aniranaway/Drone_Swarm/hardware/swarm_drone.kicad_pcb

## KiCad design hardware/swarm_drone.kicad_pcb (2026-10-28)

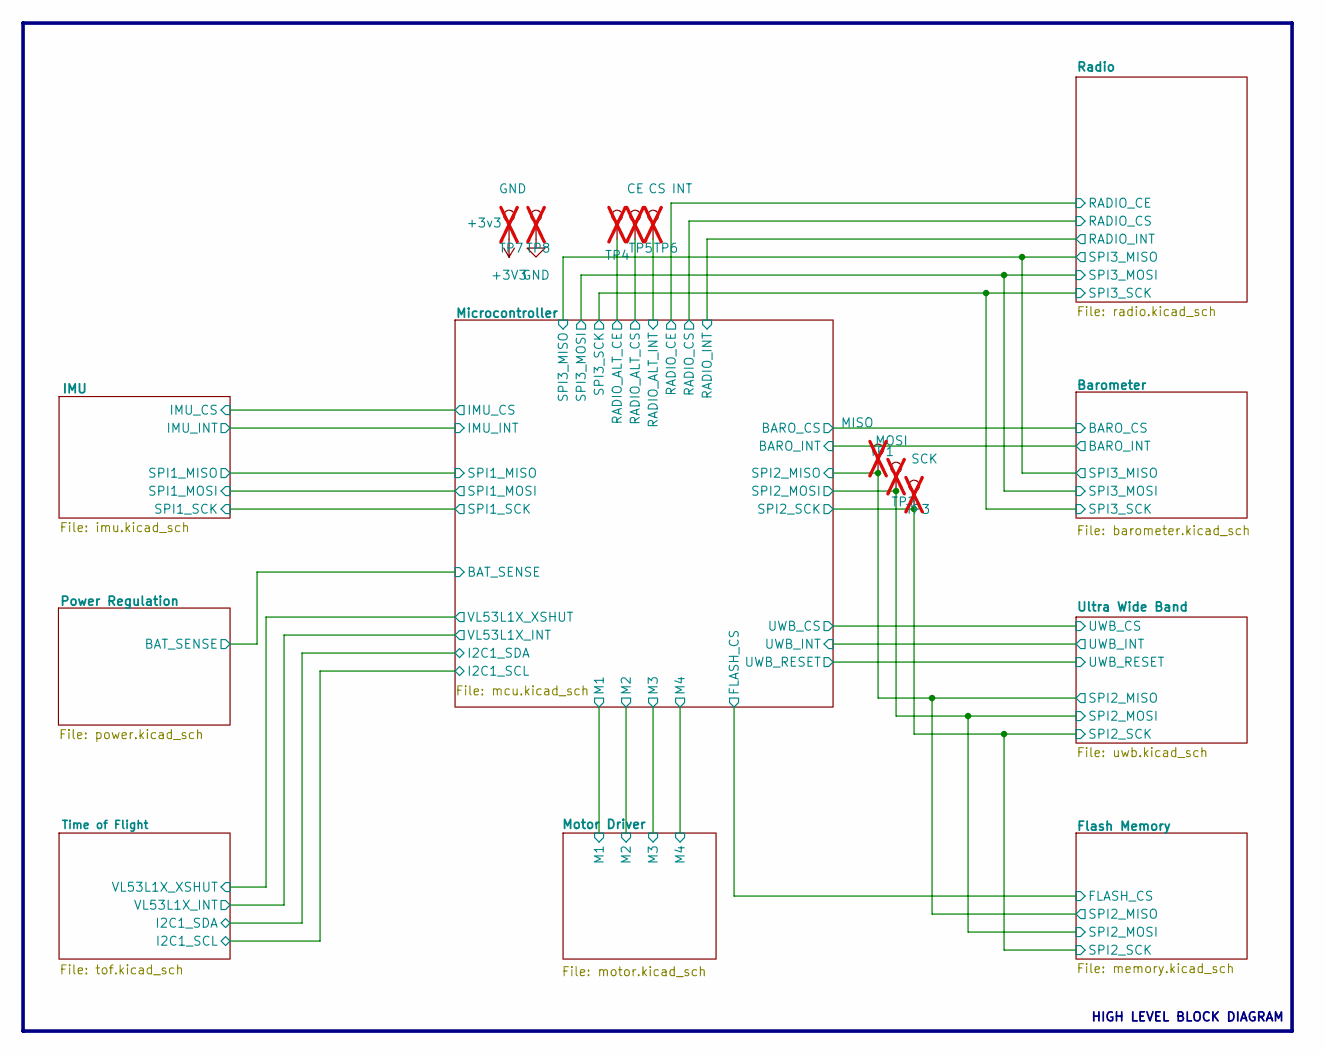
[picture p1: schematic swarm_drone.kicad_sch]

Parts:
TP1: MISO; TestPoint_Pad_1.0x1.0mm; not fitted
TP2: MOSI; TestPoint_Pad_1.0x1.0mm; not fitted
TP3: SCK; TestPoint_Pad_1.0x1.0mm; not fitted
TP4: CE; TestPoint_Pad_1.0x1.0mm; not fitted
TP5: CS; TestPoint_Pad_1.0x1.0mm; not fitted
TP6: INT; TestPoint_Pad_1.0x1.0mm; not fitted
TP7: +3v3; TestPoint_Pad_1.0x1.0mm; not fitted
TP8: GND; TestPoint_Pad_1.0x1.0mm; not fitted

Connections:
+3V3: TP7.1 (1_1); also elsewhere on the board
/Flash Memory/SPI2_MISO: TP1.1 (1_1); also elsewhere on the board
/Flash Memory/SPI2_MOSI: TP2.1 (1_1); also elsewhere on the board
/Flash Memory/SPI2_SCK: TP3.1 (1_1); also elsewhere on the board
/Microcontroller/RADIO_ALT_CE: TP4.1 (1_1); also elsewhere on the board
/Microcontroller/RADIO_ALT_CS: TP5.1 (1_1); also elsewhere on the board
/Microcontroller/RADIO_ALT_INT: TP6.1 (1_1); also elsewhere on the board
GND: TP8.1 (1_1); also elsewhere on the board

Notes on the sheet:
HIGH LEVEL BLOCK DIAGRAM

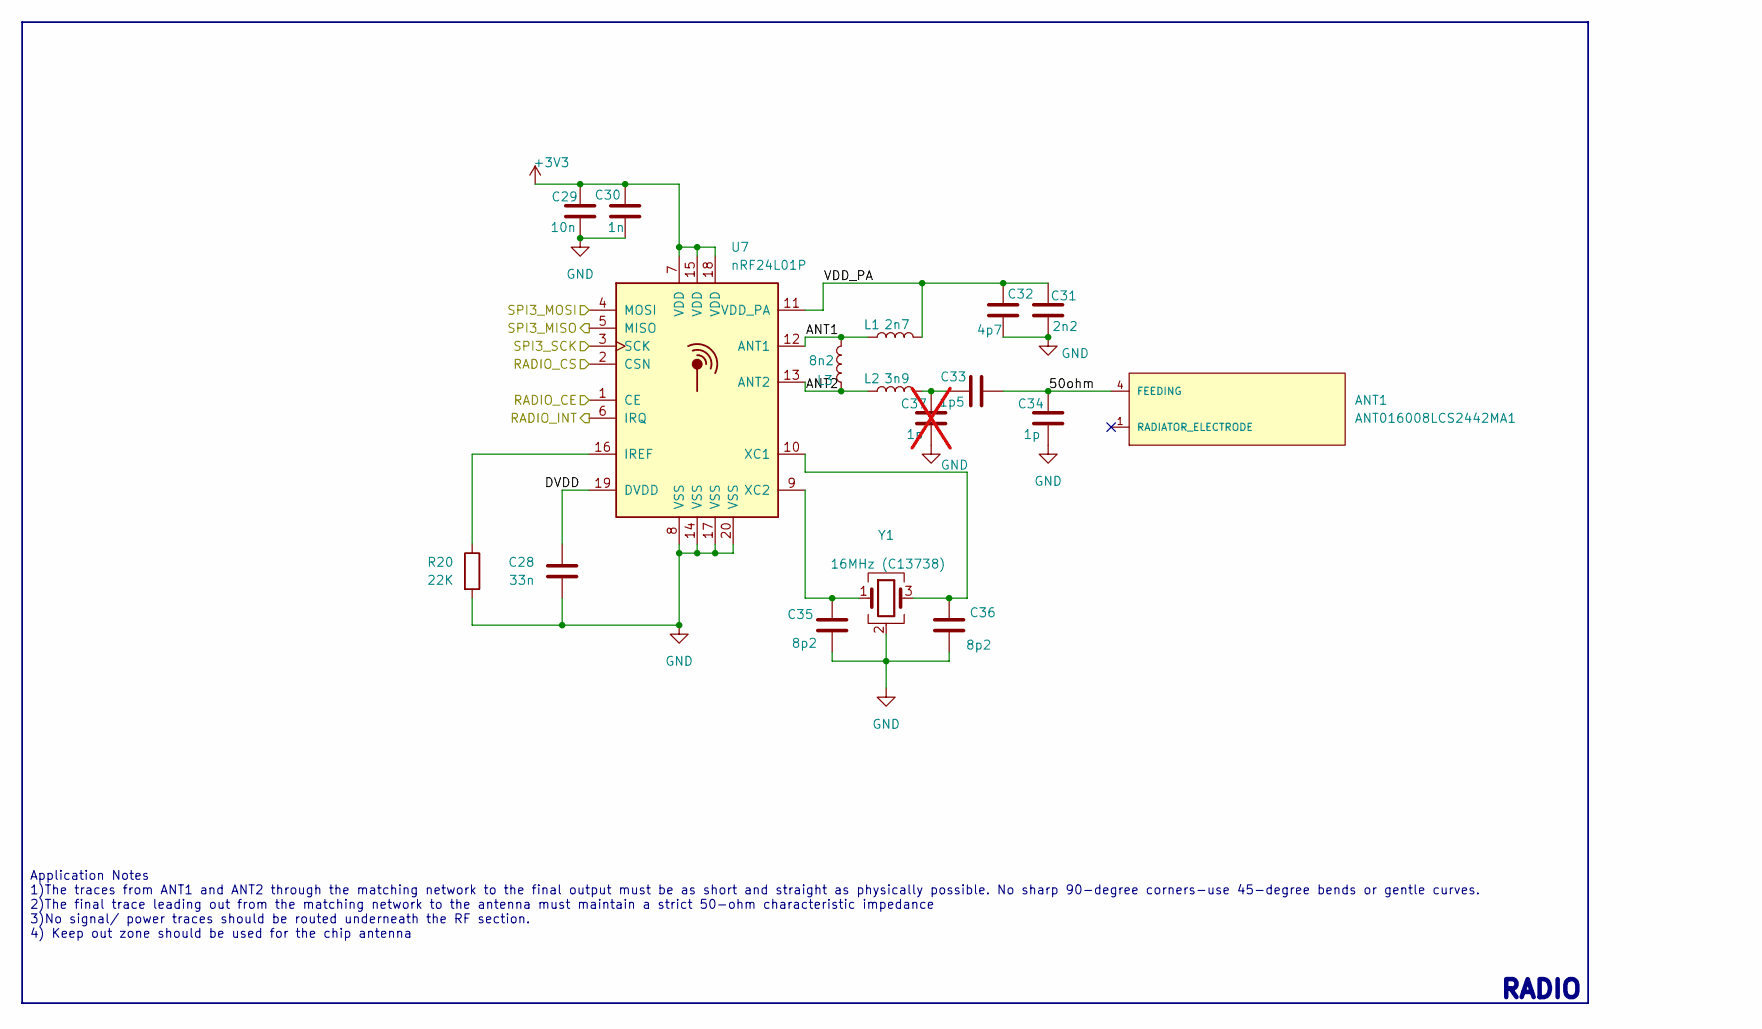
[picture p2: schematic radio.kicad_sch]

Parts:
ANT1: ANT016008LCS2442MA1; ANT_ANT016008LCS2442MA1; PARTREV sep 2016; LCSC C76585
C28: 33n; C_0603_1608Metric; LCSC C21117
C29: 10n; C_0402_1005Metric; LCSC C15195
C30: 1n; C_0402_1005Metric; LCSC C1523
C31: 2n2; C_0603_1608Metric; LCSC C1604
C32: 4p7; C_0402_1005Metric; LCSC C1569
C33: 1p5; C_0402_1005Metric; LCSC C1552
C34: 1p; C_0402_1005Metric; LCSC C1550
C35, C36: 8p2; C_0402_1005Metric; LCSC C1579
C37: 1p; C_0402_1005Metric; not fitted
L1: 2n7; L_0402_1005Metric
L2: 3n9; L_0402_1005Metric
L3: 8n2; L_0402_1005Metric
R20: 22K; R_0402_1005Metric; LCSC C25768
U7: nRF24L01P; QFN-20-1EP_4x4mm_P0.5mm_EP2.5x2.5mm; LCSC C8791
Y1: 16MHz (C13738); Crystal_SMD_3225-4Pin_3.2x2.5mm; LCSC C13738

Connections:
+3V3: C29.1, C30.1, U7.7 (VDD), U7.15 (VDD), U7.18 (VDD); also elsewhere on the board
/Barometer/SPI3_MISO: U7.5 (MISO); also elsewhere on the board
/Barometer/SPI3_MOSI: U7.4 (MOSI); also elsewhere on the board
/Barometer/SPI3_SCK: U7.3 (SCK); also elsewhere on the board
/Microcontroller/RADIO_CE: U7.1 (CE); also elsewhere on the board
/Microcontroller/RADIO_CS: U7.2 (CSN); also elsewhere on the board
/Microcontroller/RADIO_INT: U7.6 (IRQ); also elsewhere on the board
/Radio/50ohm: ANT1.4 (FEEDING_4), C33.2, C34.2
/Radio/ANT1: L1.1, L3.2, U7.12 (ANT1)
/Radio/ANT2: L2.1, L3.1, U7.13 (ANT2)
/Radio/DVDD: C28.1, U7.19 (DVDD)
/Radio/VDD_PA: C31.1, C32.1, L1.2, U7.11 (VDD_PA)
GND: C28.2, C29.2, C30.2, C31.2, C32.2, C34.1, C35.2, C36.2, C37.1, R20.2, U7.8 (VSS), U7.14 (VSS), U7.17 (VSS), U7.20 (VSS), Y1.2 (G), Y1.4 (G); also elsewhere on the board
unnamed: C33.1, C37.2, L2.2
unnamed: R20.1, U7.16 (IREF)
unnamed: C36.1, U7.10 (XC1), Y1.3
unnamed: C35.1, U7.9 (XC2), Y1.1

Notes on the sheet:
RADIO
Application Notes 1)The traces from ANT1 and ANT2 through the matching network to the final output must be as short and straight as physically possible. No sharp 90-degree corners-use 45-degree bends or gentle curves. 2)The final trace leading out from the matching network to the antenna must maint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

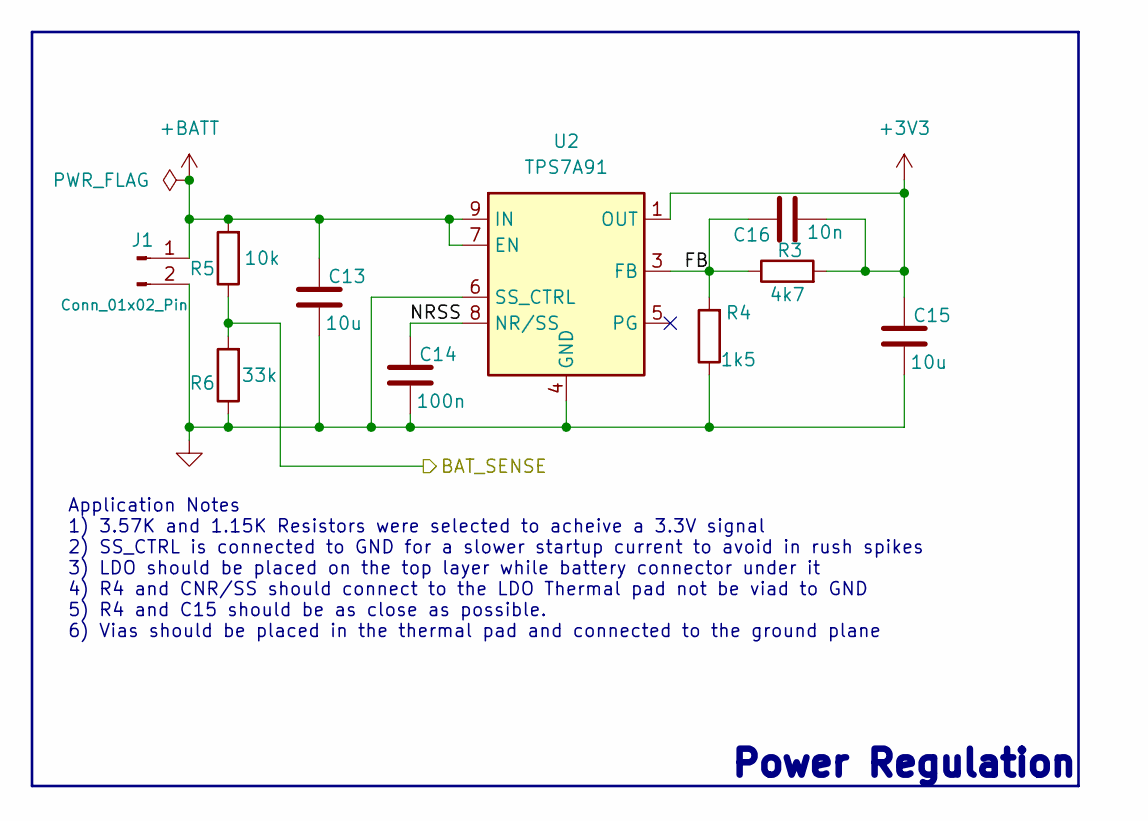
[picture p3: schematic power.kicad_sch]

Parts:
C13, C15: 10u; C_0603_1608Metric; LCSC C19702
C14: 100n; C_0402_1005Metric; LCSC C1525
C16: 10n; C_0402_1005Metric; LCSC C15195
J1: Conn_01x02_Pin; JST_PH_S2B-PH-K_1x02_P2.00mm_Horizontal; LCSC C173752
R3: 4k7; R_0402_1005Metric; LCSC C25900
R4: 1k5; R_0402_1005Metric; LCSC C25867
R5: 10k; R_0402_1005Metric; LCSC C25744
R6: 33k; R_0402_1005Metric; LCSC C25779
U2: TPS7A91; Texas_S-PDSO-N10_EP1.2x2mm_ThermalVias; LCSC C969024

Connections:
+3V3: C15.1, C16.2, R3.2, U2.1 (OUT), U2.2 (OUT); also elsewhere on the board
+BATT: C13.1, J1.1, R5.2, U2.7 (EN), U2.9 (IN), U2.10 (IN); also elsewhere on the board
/Microcontroller/BAT_SENSE: R5.1, R6.2; also elsewhere on the board
/Power Regulation/FB: C16.1, R3.1, R4.2, U2.3 (FB)
/Power Regulation/NRSS: C14.1, U2.8 (NR/SS)
GND: C13.2, C14.2, C15.2, J1.2, R4.1, R6.1, U2.4 (GND), U2.6 (SS_CTRL), U2.11 (GND); also elsewhere on the board

Notes on the sheet:
Application Notes 1) 3.57K and 1.15K Resistors were selected to acheive a 3.3V signal 2) SS_CTRL is connected to GND for a slower startup current to avoid in rush spikes 3) LDO should be placed on the top layer while battery connector under it 4) R4 and CNR/SS should connect to the LDO Thermal pad 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
Power Regulation

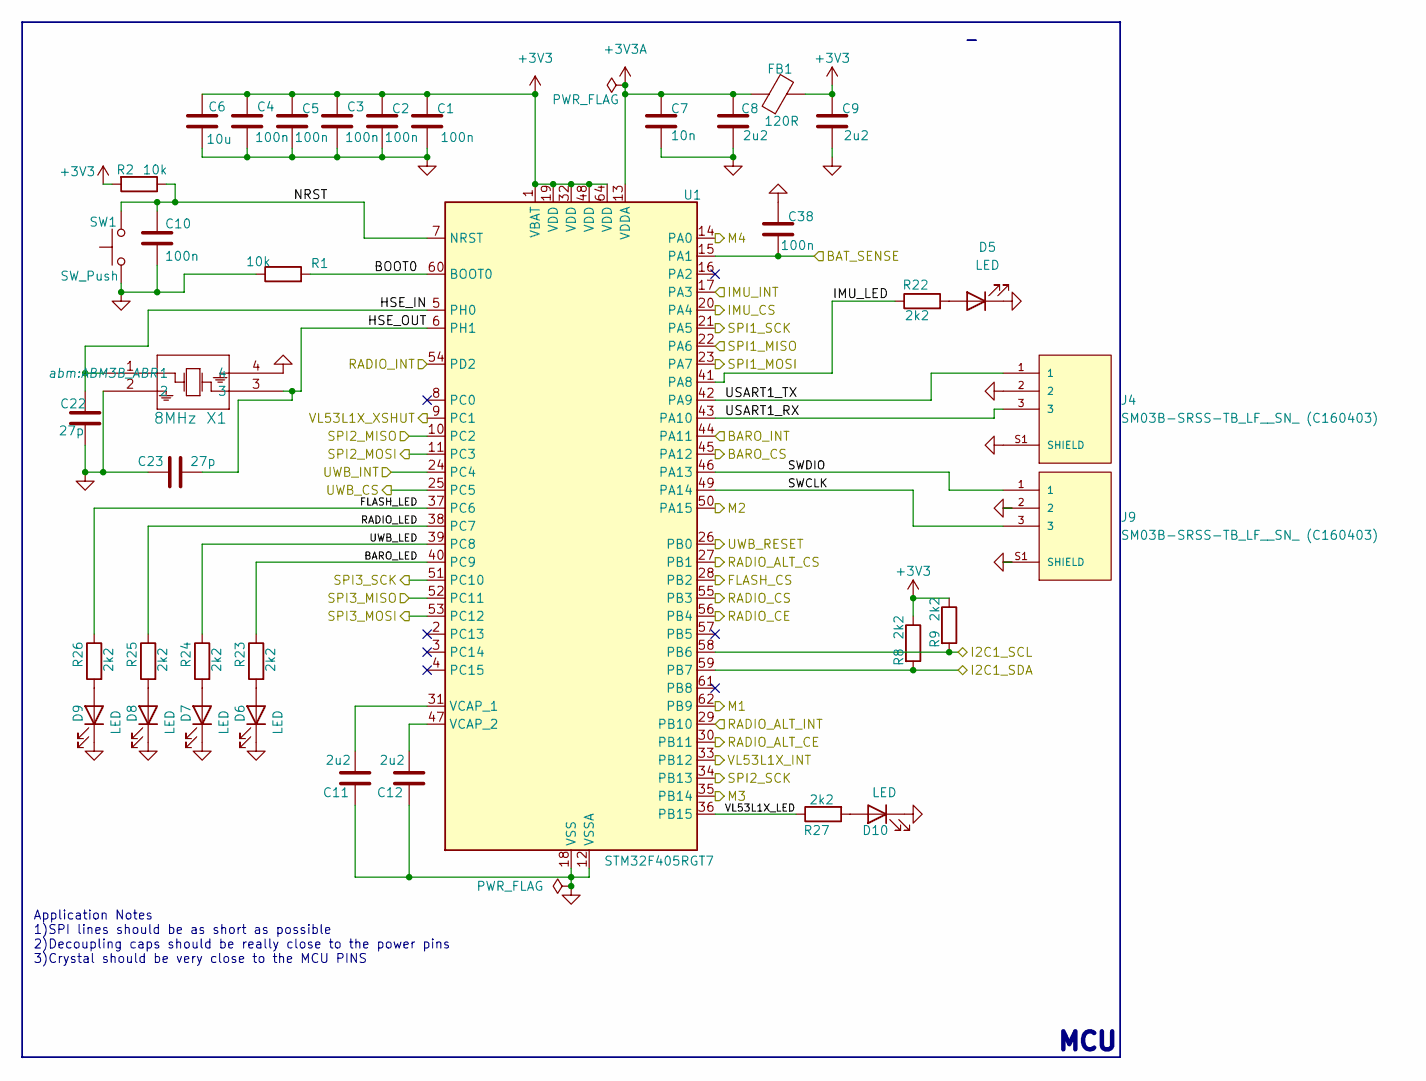
[picture p4: schematic mcu.kicad_sch]

Parts:
C1, C2, C3, C4, C5, C10, C38: 100n; C_0402_1005Metric; LCSC C1525
C6: 10u; C_0603_1608Metric; LCSC C19702
C7: 10n; C_0402_1005Metric; LCSC C15195
C8, C9, C11, C12: 2u2; C_0402_1005Metric; LCSC C12530
C22, C23: 27p; C_0402_1005Metric; LCSC C1557
D5, D6, D7, D8, D9, D10: LED; LED_0603_1608Metric; LCSC C2286
FB1: 120R; L_0603_1608Metric; LCSC C14709
J4, J9: SM03B-SRSS-TB_LF__SN_ (C160403); JST_SM03B-SRSS-TB_LF__SN_; LCSC C160403
R1, R2: 10k; R_0402_1005Metric; LCSC C25744
R8, R9, R22, R23, R24, R25, R26, R27: 2k2; R_0402_1005Metric; LCSC C25879
SW1: SW_Push; SW_SPST_TS-1088-xR020; LCSC C720477
U1: STM32F405RGT7; LQFP-64_10x10mm_P0.5mm; LCSC C1337199
X1: 8MHz; ABM3B_ABR; LCSC C83312

Connections:
+3V3: C1.1, C2.1, C3.1, C4.1, C5.1, C6.1, C9.1, FB1.2, R2.2, R8.1, R9.1, U1.1 (VBAT), U1.19 (VDD), U1.32 (VDD), U1.48 (VDD), U1.64 (VDD); also elsewhere on the board
+3V3A: C7.1, C8.1, FB1.1, U1.13 (VDDA)
/Barometer/BARO_CS: U1.45 (PA12); also elsewhere on the board
/Barometer/BARO_INT: U1.44 (PA11); also elsewhere on the board
/Barometer/SPI3_MISO: U1.52 (PC11); also elsewhere on the board
/Barometer/SPI3_MOSI: U1.53 (PC12); also elsewhere on the board
/Barometer/SPI3_SCK: U1.51 (PC10); also elsewhere on the board
/Flash Memory/FLASH_CS: U1.28 (PB2); also elsewhere on the board
/Flash Memory/SPI2_MISO: U1.10 (PC2); also elsewhere on the board
/Flash Memory/SPI2_MOSI: U1.11 (PC3); also elsewhere on the board
/Flash Memory/SPI2_SCK: U1.34 (PB13); also elsewhere on the board
/IMU/IMU_CS: U1.20 (PA4); also elsewhere on the board
/IMU/IMU_INT: U1.17 (PA3); also elsewhere on the board
/IMU/SPI1_MISO: U1.22 (PA6); also elsewhere on the board
/IMU/SPI1_MOSI: U1.23 (PA7); also elsewhere on the board
/IMU/SPI1_SCK: U1.21 (PA5); also elsewhere on the board
/Microcontroller/BARO_LED: R23.1, U1.40 (PC9)
/Microcontroller/BAT_SENSE: C38.2, U1.15 (PA1); also elsewhere on the board
/Microcontroller/BOOT0: R1.2, U1.60 (BOOT0)
/Microcontroller/FLASH_LED: R26.1, U1.37 (PC6)
/Microcontroller/HSE_IN: C22.1, U1.5 (PH0), X1.1
/Microcontroller/HSE_OUT: C23.2, U1.6 (PH1), X1.3
/Microcontroller/I2C1_SCL: R9.2, U1.58 (PB6); also elsewhere on the board
/Microcontroller/I2C1_SDA: R8.2, U1.59 (PB7); also elsewhere on the board
/Microcontroller/IMU_LED: R22.1, U1.41 (PA8)
/Microcontroller/M1: U1.62 (PB9); also elsewhere on the board
/Microcontroller/M2: U1.50 (PA15); also elsewhere on the board
/Microcontroller/M3: U1.35 (PB14); also elsewhere on the board
/Microcontroller/M4: U1.14 (PA0); also elsewhere on the board
/Microcontroller/NRST: C10.1, R2.1, SW1.2, U1.7 (NRST)
/Microcontroller/RADIO_ALT_CE: U1.30 (PB11); also elsewhere on the board
/Microcontroller/RADIO_ALT_CS: U1.27 (PB1); also elsewhere on the board
/Microcontroller/RADIO_ALT_INT: U1.29 (PB10); also elsewhere on the board
/Microcontroller/RADIO_CE: U1.56 (PB4); also elsewhere on the board
/Microcontroller/RADIO_CS: U1.55 (PB3); also elsewhere on the board
/Microcontroller/RADIO_INT: U1.54 (PD2); also elsewhere on the board
/Microcontroller/RADIO_LED: R25.1, U1.38 (PC7)
/Microcontroller/SWCLK: J9.3, U1.49 (PA14)
/Microcontroller/SWDIO: J9.1, U1.46 (PA13)
/Microcontroller/USART1_RX: J4.3, U1.43 (PA10)
/Microcontroller/USART1_TX: J4.1, U1.42 (PA9)
/Microcontroller/UWB_CS: U1.25 (PC5); also elsewhere on the board
/Microcontroller/UWB_INT: U1.24 (PC4); also elsewhere on the board
/Microcontroller/UWB_LED: R24.1, U1.39 (PC8)
/Microcontroller/UWB_RESET: U1.26 (PB0); also elsewhere on the board
/Microcontroller/VL53L1X_INT: U1.33 (PB12); also elsewhere on the board
/Microcontroller/VL53L1X_LED: R27.1, U1.36 (PB15)
/Microcontroller/VL53L1X_XSHUT: U1.9 (PC1); also elsewhere on the board
GND: C1.2, C2.2, C3.2, C4.2, C5.2, C6.2, C7.2, C8.2, C9.2, C10.2, C11.1, C12.1, C22.2, C23.1, C38.1, D5.1 (K), D6.1 (K), D7.1 (K), D8.1 (K), D9.1 (K), D10.1 (K), J4.2, J4.S1 (SHIELD), J4.S2 (SHIELD), J9.2, J9.S1 (SHIELD), J9.S2 (SHIELD), R1.1, SW1.1, U1.12 (VSSA), U1.18 (VSS), U1.63 (VSS), X1.2, X1.4; also elsewhere on the board
unnamed: D5.2 (A), R22.2
unnamed: D6.2 (A), R23.2
unnamed: D7.2 (A), R24.2
unnamed: D8.2 (A), R25.2
unnamed: D9.2 (A), R26.2
unnamed: D10.2 (A), R27.2
unnamed: C11.2, U1.31 (VCAP_1)
unnamed: C12.2, U1.47 (VCAP_2)

Notes on the sheet:
Application Notes 1)SPI lines should be as short as possible 2)Decoupling caps should be really close to the power pins 3)Crystal should be very close to the MCU PINS
MCU

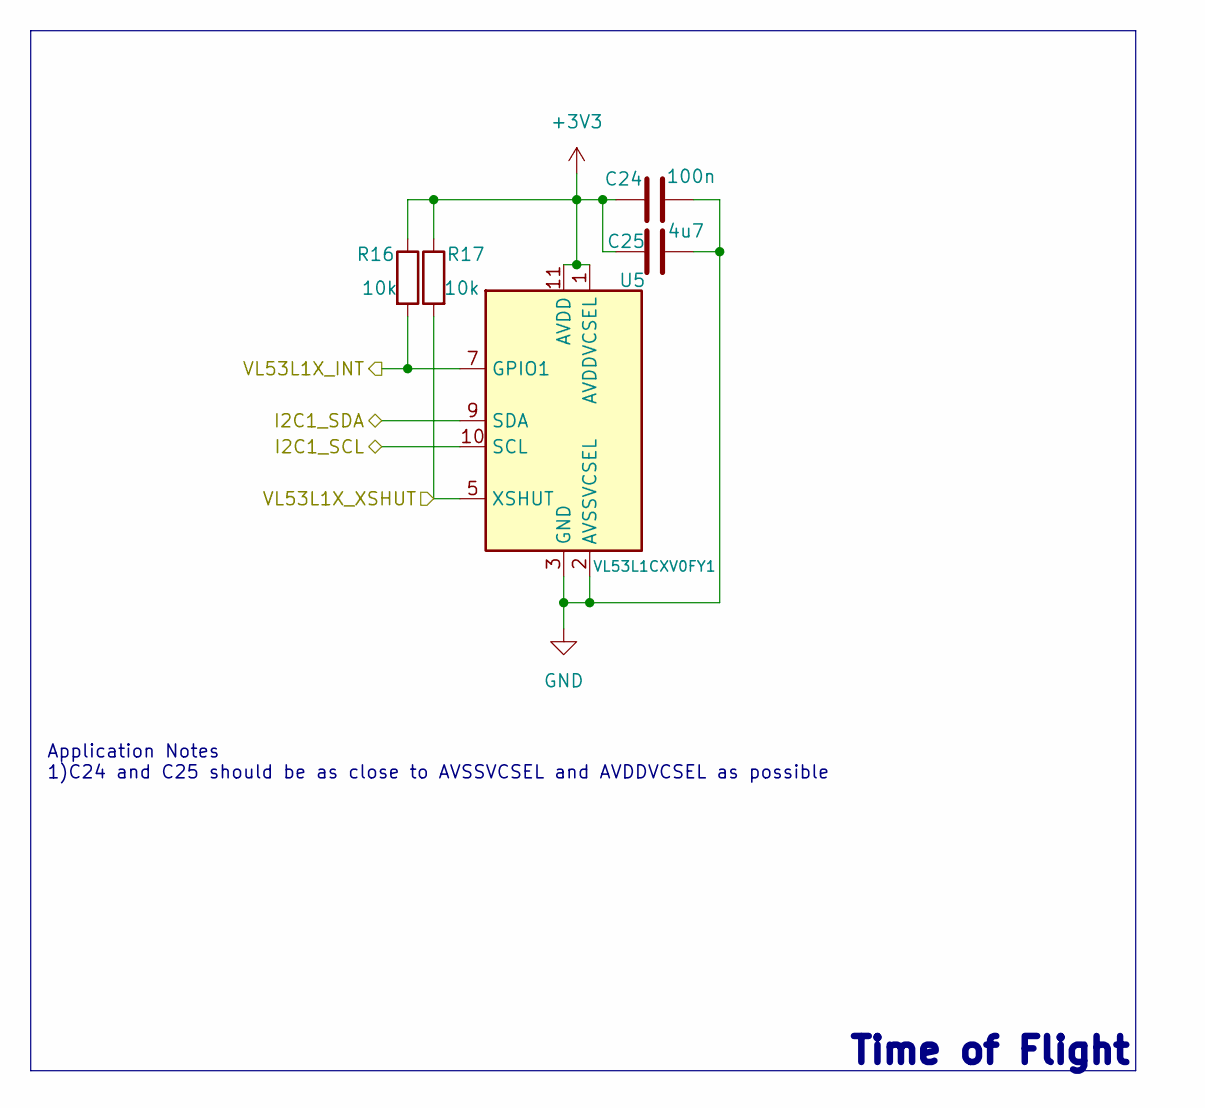
[picture p5: schematic tof.kicad_sch]

Parts:
C24: 100n; C_0402_1005Metric; LCSC C1525
C25: 4u7; C_0603_1608Metric; LCSC C19666
R16, R17: 10k; R_0402_1005Metric; LCSC C25744
U5: VL53L1CXV0FY1; ST_VL53L1x; LCSC C190004

Connections:
+3V3: C24.1, C25.1, R16.1, R17.1, U5.1 (AVDDVCSEL), U5.11 (AVDD); also elsewhere on the board
/Microcontroller/I2C1_SCL: U5.10 (SCL); also elsewhere on the board
/Microcontroller/I2C1_SDA: U5.9 (SDA); also elsewhere on the board
/Microcontroller/VL53L1X_INT: R16.2, U5.7 (GPIO1); also elsewhere on the board
/Microcontroller/VL53L1X_XSHUT: R17.2, U5.5 (XSHUT); also elsewhere on the board
GND: C24.2, C25.2, U5.2 (AVSSVCSEL), U5.3 (GND), U5.4 (GND), U5.6 (GND), U5.12 (GND); also elsewhere on the board

Notes on the sheet:
Application Notes 1)C24 and C25 should be as close to AVSSVCSEL and AVDDVCSEL as possible
Time of Flight

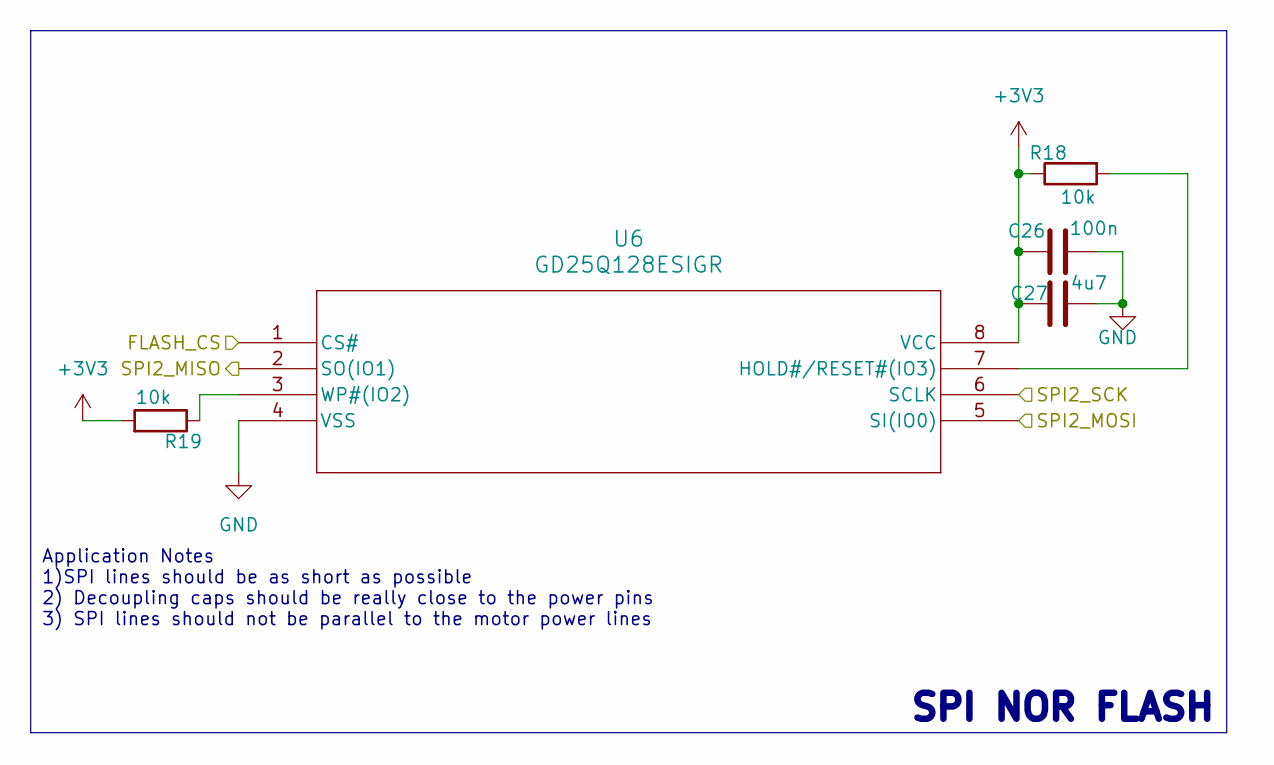
[picture p6: schematic memory.kicad_sch]

Parts:
C26: 100n; C_0402_1005Metric; LCSC C1525
C27: 4u7; C_0603_1608Metric; LCSC C19666
R18, R19: 10k; R_0402_1005Metric; LCSC C25744
U6: GD25Q128ESIGR; SOP8_208MIL_GDV; LCSC C2928891

Connections:
+3V3: C26.1, C27.1, R18.1, R19.2, U6.8 (VCC); also elsewhere on the board
/Flash Memory/FLASH_CS: U6.1 (CS#); also elsewhere on the board
/Flash Memory/SPI2_MISO: U6.2 (SO(IO1)); also elsewhere on the board
/Flash Memory/SPI2_MOSI: U6.5 (SI(IO0)); also elsewhere on the board
/Flash Memory/SPI2_SCK: U6.6 (SCLK); also elsewhere on the board
GND: C26.2, C27.2, U6.4 (VSS); also elsewhere on the board
unnamed: R18.2, U6.7 (HOLD#/RESET#(IO3))
unnamed: R19.1, U6.3 (WP#(IO2))

Notes on the sheet:
SPI NOR FLASH
Application Notes 1)SPI lines should be as short as possible 2) Decoupling caps should be really close to the power pins 3) SPI lines should not be parallel to the motor power lines

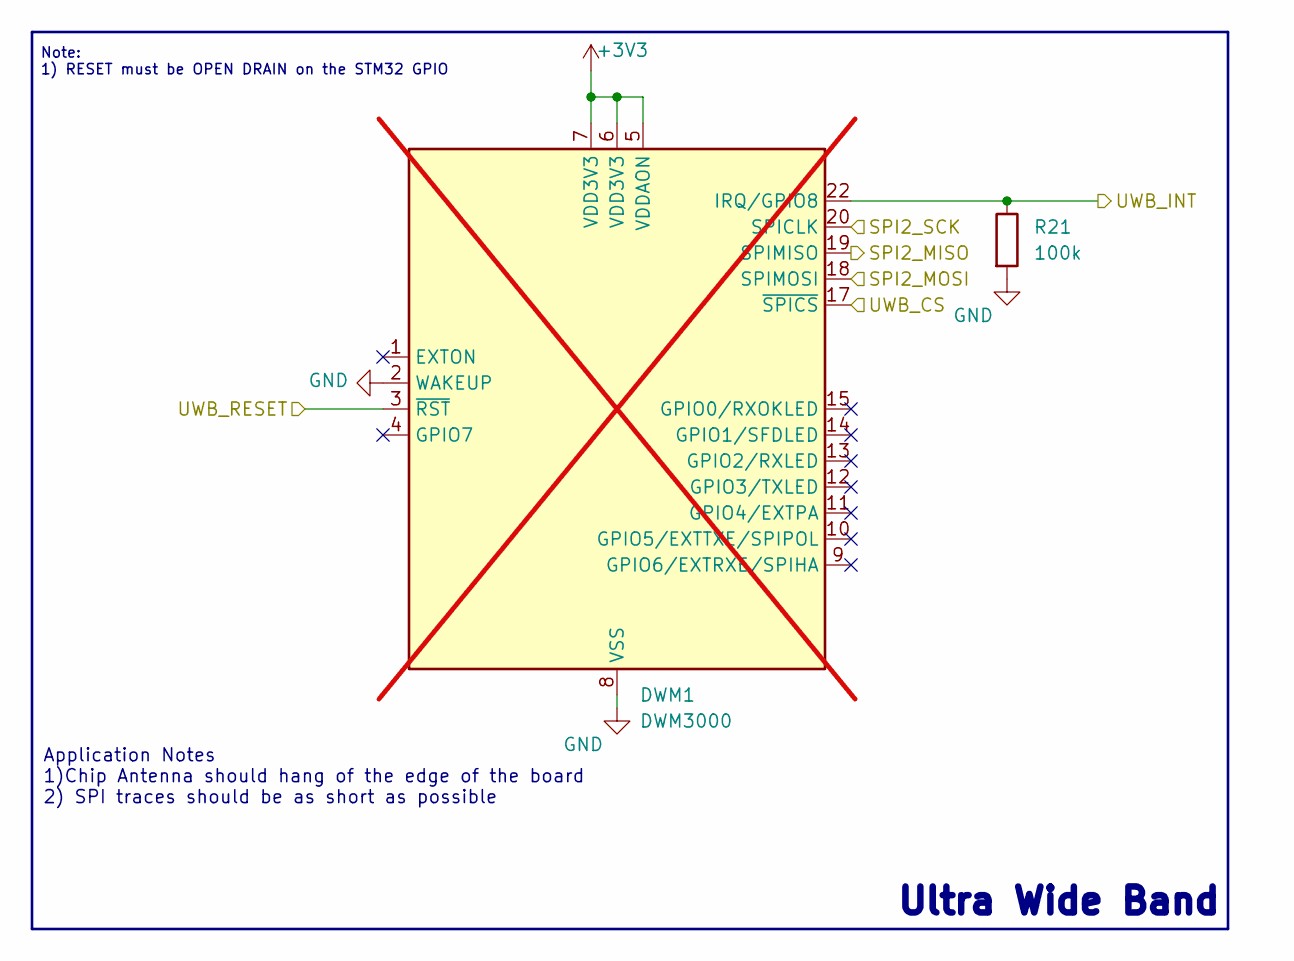
[picture p7: schematic uwb.kicad_sch]

Parts:
DWM1: DWM3000; DWM1000; not fitted
R21: 100k; R_0402_1005Metric; LCSC C25741

Connections:
+3V3: DWM1.5 (VDDAON), DWM1.6 (VDD3V3), DWM1.7 (VDD3V3); also elsewhere on the board
/Flash Memory/SPI2_MISO: DWM1.19 (SPIMISO); also elsewhere on the board
/Flash Memory/SPI2_MOSI: DWM1.18 (SPIMOSI); also elsewhere on the board
/Flash Memory/SPI2_SCK: DWM1.20 (SPICLK); also elsewhere on the board
/Microcontroller/UWB_CS: DWM1.17 (~SPICS); also elsewhere on the board
/Microcontroller/UWB_INT: DWM1.22 (IRQ/GPIO8), R21.1; also elsewhere on the board
/Microcontroller/UWB_RESET: DWM1.3 (~RST); also elsewhere on the board
GND: DWM1.2 (WAKEUP), DWM1.8 (VSS), DWM1.16 (VSS), DWM1.21 (VSS), DWM1.23 (VSS), DWM1.24 (VSS), R21.2; also elsewhere on the board

Notes on the sheet:
Application Notes 1)Chip Antenna should hang of the edge of the board 2) SPI traces should be as short as possible
Ultra Wide Band
Note: 1) RESET must be OPEN DRAIN on the STM32 GPIO

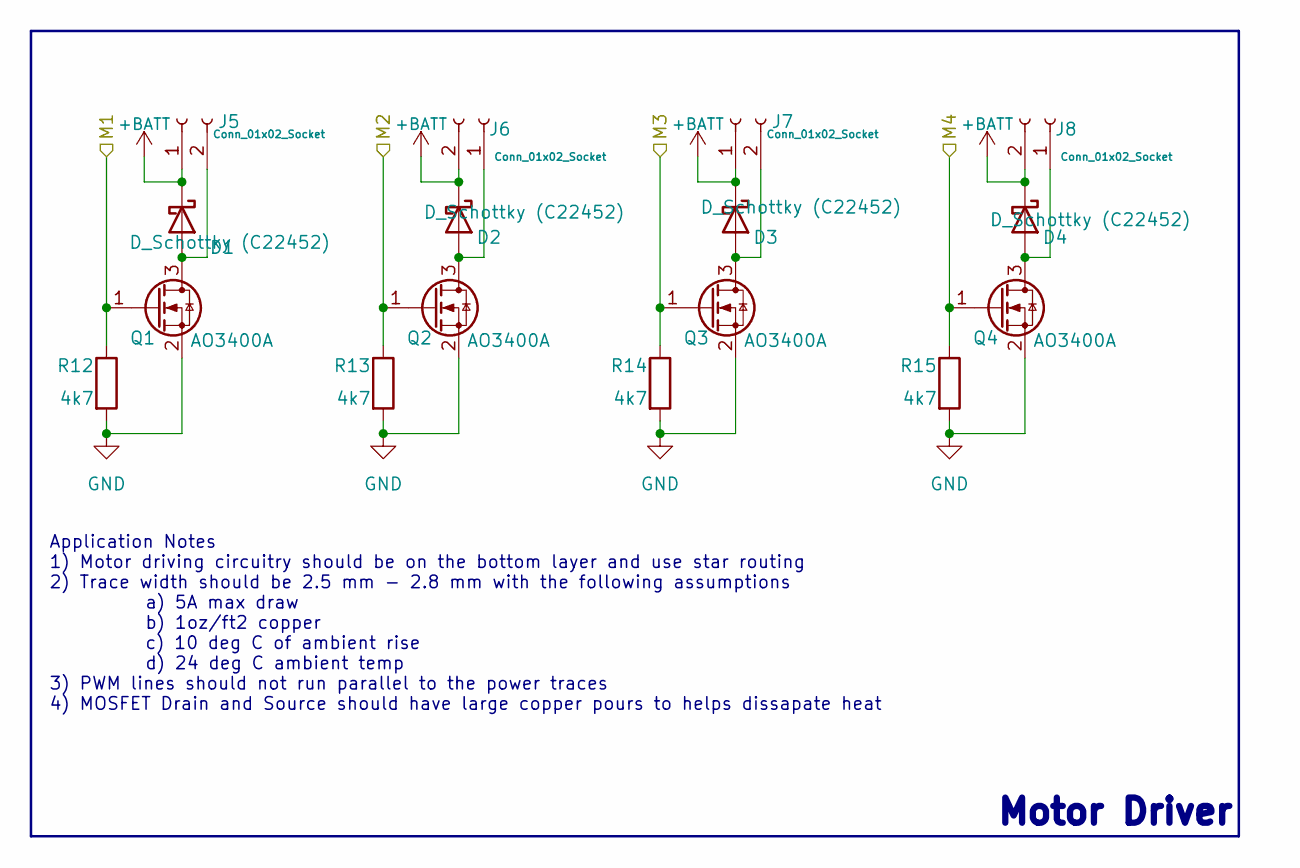
[picture p8: schematic motor.kicad_sch]

Parts:
D1, D2, D3, D4: D_Schottky (C22452); D_SMA; LCSC C22452
J5, J6, J7, J8: Conn_01x02_Socket; JST_S2B-ZR-3.4_LF__SN_; LCSC C160729
Q1, Q2, Q3, Q4: AO3400A; SOT-23; LCSC C20917
R12, R13, R14, R15: 4k7; R_0402_1005Metric; LCSC C25900

Connections:
+BATT: D1.1 (K), D2.1 (K), D3.1 (K), D4.1 (K), J5.1, J6.2, J7.1, J8.2; also elsewhere on the board
/Microcontroller/M1: Q1.1 (G), R12.1; also elsewhere on the board
/Microcontroller/M2: Q2.1 (G), R13.1; also elsewhere on the board
/Microcontroller/M3: Q3.1 (G), R14.1; also elsewhere on the board
/Microcontroller/M4: Q4.1 (G), R15.1; also elsewhere on the board
GND: Q1.2 (S), Q2.2 (S), Q3.2 (S), Q4.2 (S), R12.2, R13.2, R14.2, R15.2; also elsewhere on the board
unnamed: D1.2 (A), J5.2, Q1.3 (D)
unnamed: D2.2 (A), J6.1, Q2.3 (D)
unnamed: D3.2 (A), J7.2, Q3.3 (D)
unnamed: D4.2 (A), J8.1, Q4.3 (D)

Notes on the sheet:
Application Notes 1) Motor driving circuitry should be on the bottom layer and use star routing 2) Trace width should be 2.5 mm - 2.8 mm with the following assumptions a) 5A max draw b) 1oz/ft2 copper c) 10 deg C of ambient rise d) 24 deg C ambient temp 3) PWM lines should not run parallel to the p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
Motor Driver

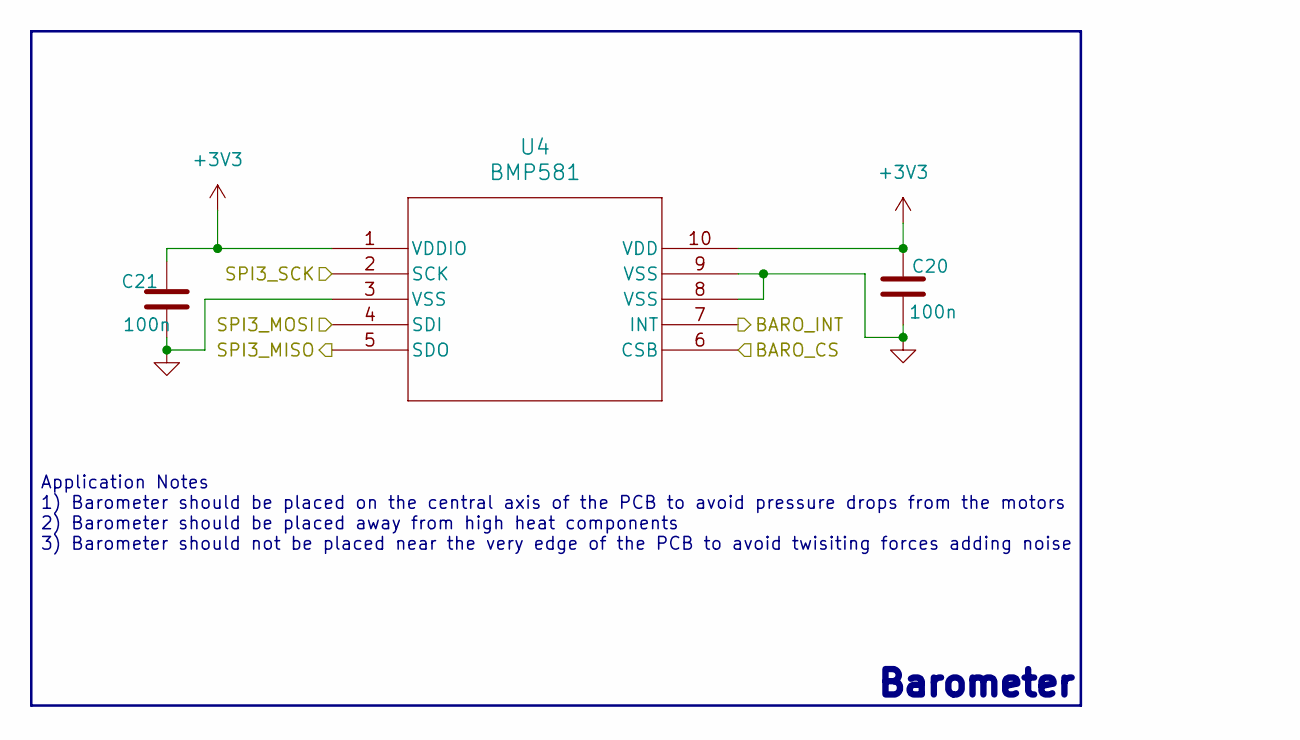
[picture p9: schematic barometer.kicad_sch]

Parts:
C20, C21: 100n; C_0402_1005Metric; LCSC C1525
U4: BMP581; QFN10_BMP581_BOS; LCSC C5362283

Connections:
+3V3: C20.1, C21.1, U4.1 (VDDIO), U4.10 (VDD); also elsewhere on the board
/Barometer/BARO_CS: U4.6 (CSB); also elsewhere on the board
/Barometer/BARO_INT: U4.7 (INT); also elsewhere on the board
/Barometer/SPI3_MISO: U4.5 (SDO); also elsewhere on the board
/Barometer/SPI3_MOSI: U4.4 (SDI); also elsewhere on the board
/Barometer/SPI3_SCK: U4.2 (SCK); also elsewhere on the board
GND: C20.2, C21.2, U4.3 (VSS), U4.8 (VSS), U4.9 (VSS); also elsewhere on the board

Notes on the sheet:
Application Notes 1) Barometer should be placed on the central axis of the PCB to avoid pressure drops from the motors 2) Barometer should be placed away from high heat components 3) Barometer should not be placed near the very edge of the PCB to avoid twisiting forces adding noise
Barometer

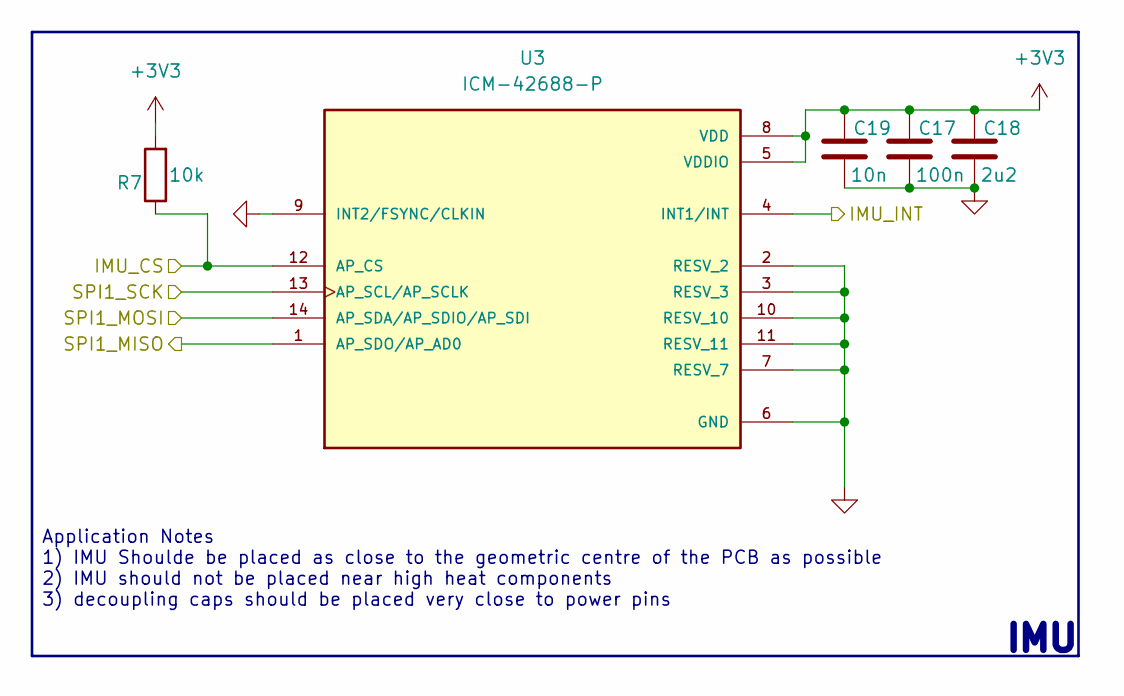
[picture p10: schematic imu.kicad_sch]

Parts:
C17: 100n; C_0402_1005Metric; LCSC C1525
C18: 2u2; C_0402_1005Metric; LCSC C12530
C19: 10n; C_0402_1005Metric; LCSC C15195
R7: 10k; R_0402_1005Metric; LCSC C25744
U3: ICM-42688-P; PQFN50P300X250X97-14N; PARTREV 1.2; LCSC C1850418

Connections:
+3V3: C17.1, C18.1, C19.1, R7.2, U3.5 (VDDIO), U3.8 (VDD); also elsewhere on the board
/IMU/IMU_CS: R7.1, U3.12 (AP_CS); also elsewhere on the board
/IMU/IMU_INT: U3.4 (INT1/INT); also elsewhere on the board
/IMU/SPI1_MISO: U3.1 (AP_SDO/AP_AD0); also elsewhere on the board
/IMU/SPI1_MOSI: U3.14 (AP_SDA/AP_SDIO/AP_SDI); also elsewhere on the board
/IMU/SPI1_SCK: U3.13 (AP_SCL/AP_SCLK); also elsewhere on the board
GND: C17.2, C18.2, C19.2, U3.2 (RESV_2), U3.3 (RESV_3), U3.6 (GND), U3.7 (RESV_7), U3.9 (INT2/FSYNC/CLKIN), U3.10 (RESV_10), U3.11 (RESV_11); also elsewhere on the board

Notes on the sheet:
Application Notes 1) IMU Shoulde be placed as close to the geometric centre of the PCB as possible 2) IMU should not be placed near high heat components 3) decoupling caps should be placed very close to power pins
IMU

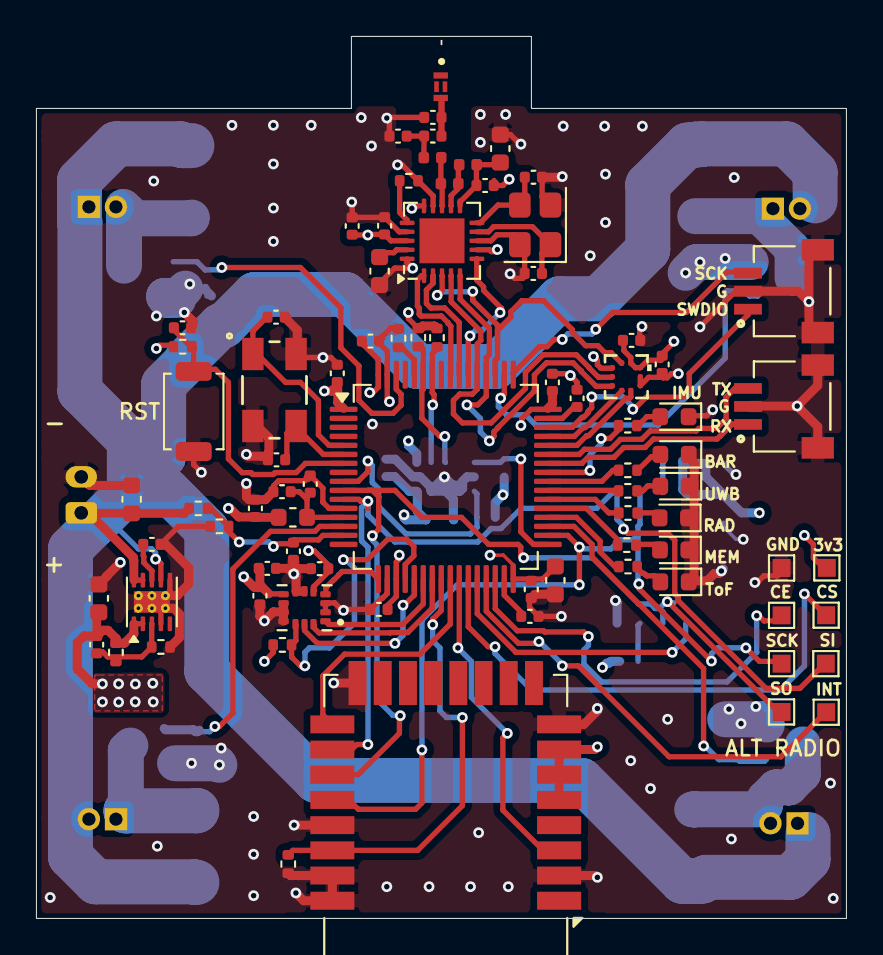
[picture p11: board swarm_drone.kicad_pcb from above]

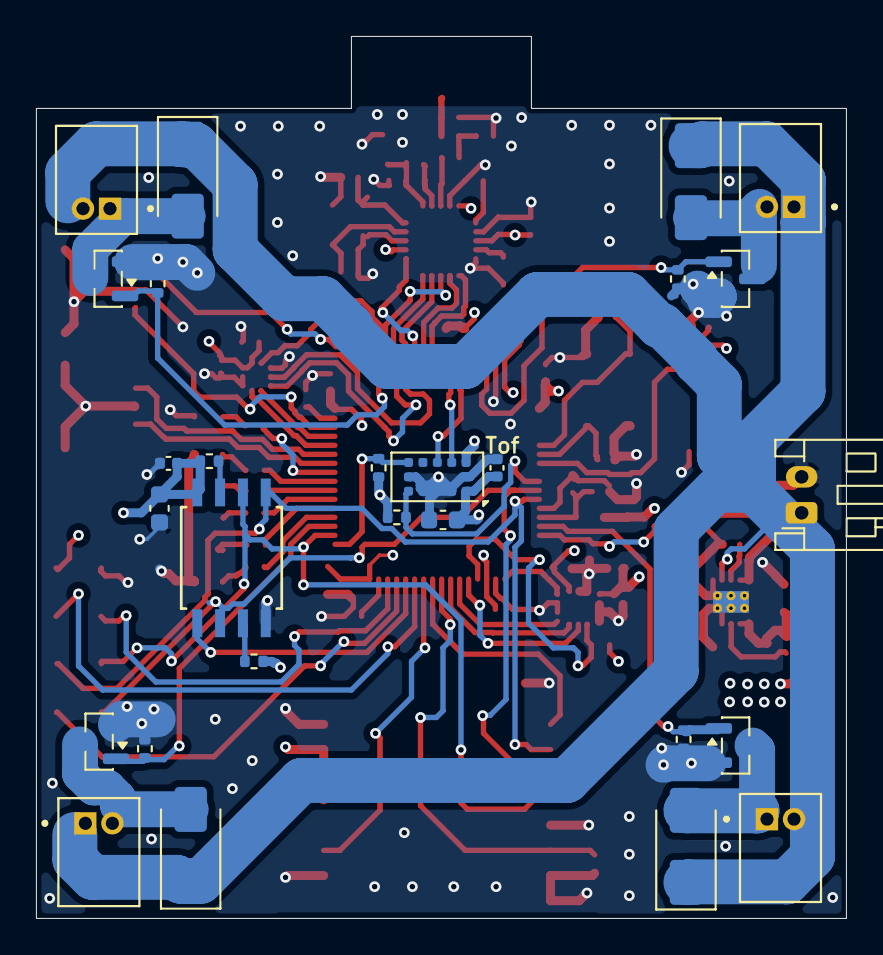
[picture p12: board swarm_drone.kicad_pcb from below]

Board: 4 copper layers, 45.0 x 49.0 mm, 108 parts (27 on the bottom side), 75 nets.
