aniranaway/Drone_Swarm/firmware/firmware.ioc

Mcu.UserName=STM32F405RGTx
PA0-WKUP.GPIO_Label=M4_PWM
PA0-WKUP.Signal=S_TIM5_CH1
PA1.GPIO_Label=BAT_SENSE
PA1.Signal=ADCx_IN1
PA10.Signal=USART1_RX
PA11.GPIO_Label=BARO_INT
PA11.Signal=GPXTI11
PA12.GPIO_Label=BARO_CS
PA12.Signal=GPIO_Output
PA13.Signal=SYS_JTMS-SWDIO
PA14.Signal=SYS_JTCK-SWCLK
PA15.GPIO_Label=M2_PWM
PA15.Signal=S_TIM2_CH1_ETR
PA3.GPIO_Label=IMU_INT
PA3.Signal=GPXTI3
PA4.GPIO_Label=IMU_CS
PA4.Signal=GPIO_Output
PA5.Signal=SPI1_SCK
PA6.Signal=SPI1_MISO
PA7.Signal=SPI1_MOSI
PA8.GPIO_Label=IMU_LED
PA8.Signal=GPIO_Output
PA9.Signal=USART1_TX
PB0.GPIO_Label=UWB_RESET
PB0.Signal=GPIO_Output
PB1.GPIO_Label=RADIO_ALT_CS
PB1.Signal=GPIO_Output
PB10.GPIO_Label=RADIO_ALT_INT
PB10.Signal=GPXTI10
PB11.GPIO_Label=RADIO_ALT_CE
PB11.Signal=GPIO_Output
PB12.GPIO_Label=VL53L1X_INT
PB12.Signal=GPXTI12
PB13.Signal=SPI2_SCK
PB14.GPIO_Label=M3_PWM
PB14.Signal=S_TIM12_CH1
PB15.GPIO_Label=VL53L1X_LED
PB15.Signal=GPIO_Output
PB2.GPIO_Label=FLASH_CS
PB2.Signal=GPIO_Output
PB3.GPIO_Label=RADIO_CS
PB3.Signal=GPIO_Output
PB4.GPIO_Label=RADIO_CE
PB4.Signal=GPIO_Output
PB6.Signal=I2C1_SCL
PB7.Signal=I2C1_SDA
PB9.GPIO_Label=M1_PWM
PB9.Signal=S_TIM11_CH1
PC1.GPIO_Label=VL53L1X_XSHUT
PC1.Signal=GPIO_Output
PC10.Signal=SPI3_SCK
PC11.Signal=SPI3_MISO
PC12.Signal=SPI3_MOSI
PC2.Signal=SPI2_MISO
PC3.Signal=SPI2_MOSI
PC4.GPIO_Label=UWB_INT
PC4.Signal=GPXTI4
PC5.GPIO_Label=UWB_CS
PC5.Signal=GPIO_Output
PC6.GPIO_Label=FLASH_LED
PC6.Signal=GPIO_Output
PC7.GPIO_Label=RADIO_LED
PC7.Signal=GPIO_Output
PC8.GPIO_Label=UWB_LED
PC8.Signal=GPIO_Output
PC9.GPIO_Label=BARO_LED
PC9.Signal=GPIO_Output
PD2.GPIO_Label=RADIO_INT
PD2.Signal=GPXTI2
PH0-OSC_IN.Signal=RCC_OSC_IN
PH1-OSC_OUT.Signal=RCC_OSC_OUT
