aniranaway/Drone_Swarm/(commit log)

2026-10-10 docs(component_selection_analysis): Added IMU selection
2026-10-11 docs(component_selection_analysis) : Added Tof sensor analysis
2026-10-12 feat(hardware): initialize KiCad project structure for swarm drone
2026-10-12 feat(hardware): add STM32F405 core power, decoupling, reset, and boot schematic
2026-10-13 feat(kicad): Added MCU schematic and LDO schematic
2026-10-13 feat: Added schematic design for IMU and Barometer. Included reference sheets and open sourcer models
2026-10-13 feat(kicad): Added heirarchical subsheets and block diagrams to indicate system behavior
    Added barometer schematic
2026-10-13 feat(kicad): Added heirarchical nodes for baro, imu. Added motor driving logic and updated pinouts
2026-10-14 feat(kicad): Added several open sourced footprint libraries, finished schematic design for nrf, uwb, tof, flash, motors and added all reference material to refs folder
2026-10-14 feat(kicad): Finished initial draft of the schematic design All pinouts are set
2026-10-14 feat (kicad + cubemx): Updated pin names and formatted text fields
2026-10-14 feat(kicad): Cleared ERC errors and assigned footprints for all parts
2026-10-14 feat(kicad): Added Application notes for the LDO
2026-10-14 feat(kicad): Added application notes for the IMU
2026-10-14 feat(kicad): Added Barometer application notes
2026-10-14 feat (kicad): Added Motor driving application notes
2026-10-15 feat(kicad): Added VL53l10x application notes
2026-10-15 feat(kicad): Added flash memory application notes
2026-10-15 feat(kicad): Added radio application notes
2026-10-15 feat(kicad): Added uwb application notes
2026-10-15 feat(kicad): Added mcu application notes
2026-10-15 feat(kicad): Fixed formatiing
2026-10-15 feat(kicad): Initial pcb layout
2026-10-16 feat(kicad): Added step files for missing parts
    changed flyback diode to SMA part with 5A max
    Redid initial layout
2026-10-17 feat(kicad): Updated schematic to keep traces shorter on the layout Restarting layout
2026-10-17 feat(kicad): Rerouted board and changed nets to provide ease in routing
2026-10-17 feat(kicad): Updated via spacing to prevent cutting up the ground plane
2026-10-18 feat(kicad): Updated traces to reduce power plane slotting Finished inital pass of the NRF layout
2026-10-19 feat(kicad): Added chip antenna footprint Still deciding between chip vs trace
2026-10-24 feat(kicad): After several revisions finished rf section and improved ground plane topology and signal distances
2026-10-25 feat(kicad): Routing complete, assigning jlc components to each footprint
2026-10-28 feat(kicad): Cleaned up routing and picked LCSC parts for several components
